philpem/NABU-Adaptor/LTSpice/PowerOnReset.asc

C1: polcap; 10µ; V=4 Irms=120m Rser=5.1 Lser=0 mfg="Vishay" pn="293D106M004A" type="Tantalum"
D1: diode; 1N4148
R1: res; 3k3
R2: res; 1k5
R3: res; 12k
U1: LT1017
V1: voltage; 5
V2: voltage; 1.4
Named nets: 0
.tran .5 startup
