philpem/NABU-Adaptor/Kicad/NABUAdaptor.kicad_sch

## KiCad design Kicad/NABUAdaptor.kicad_sch (2024-06-13, an earlier design)

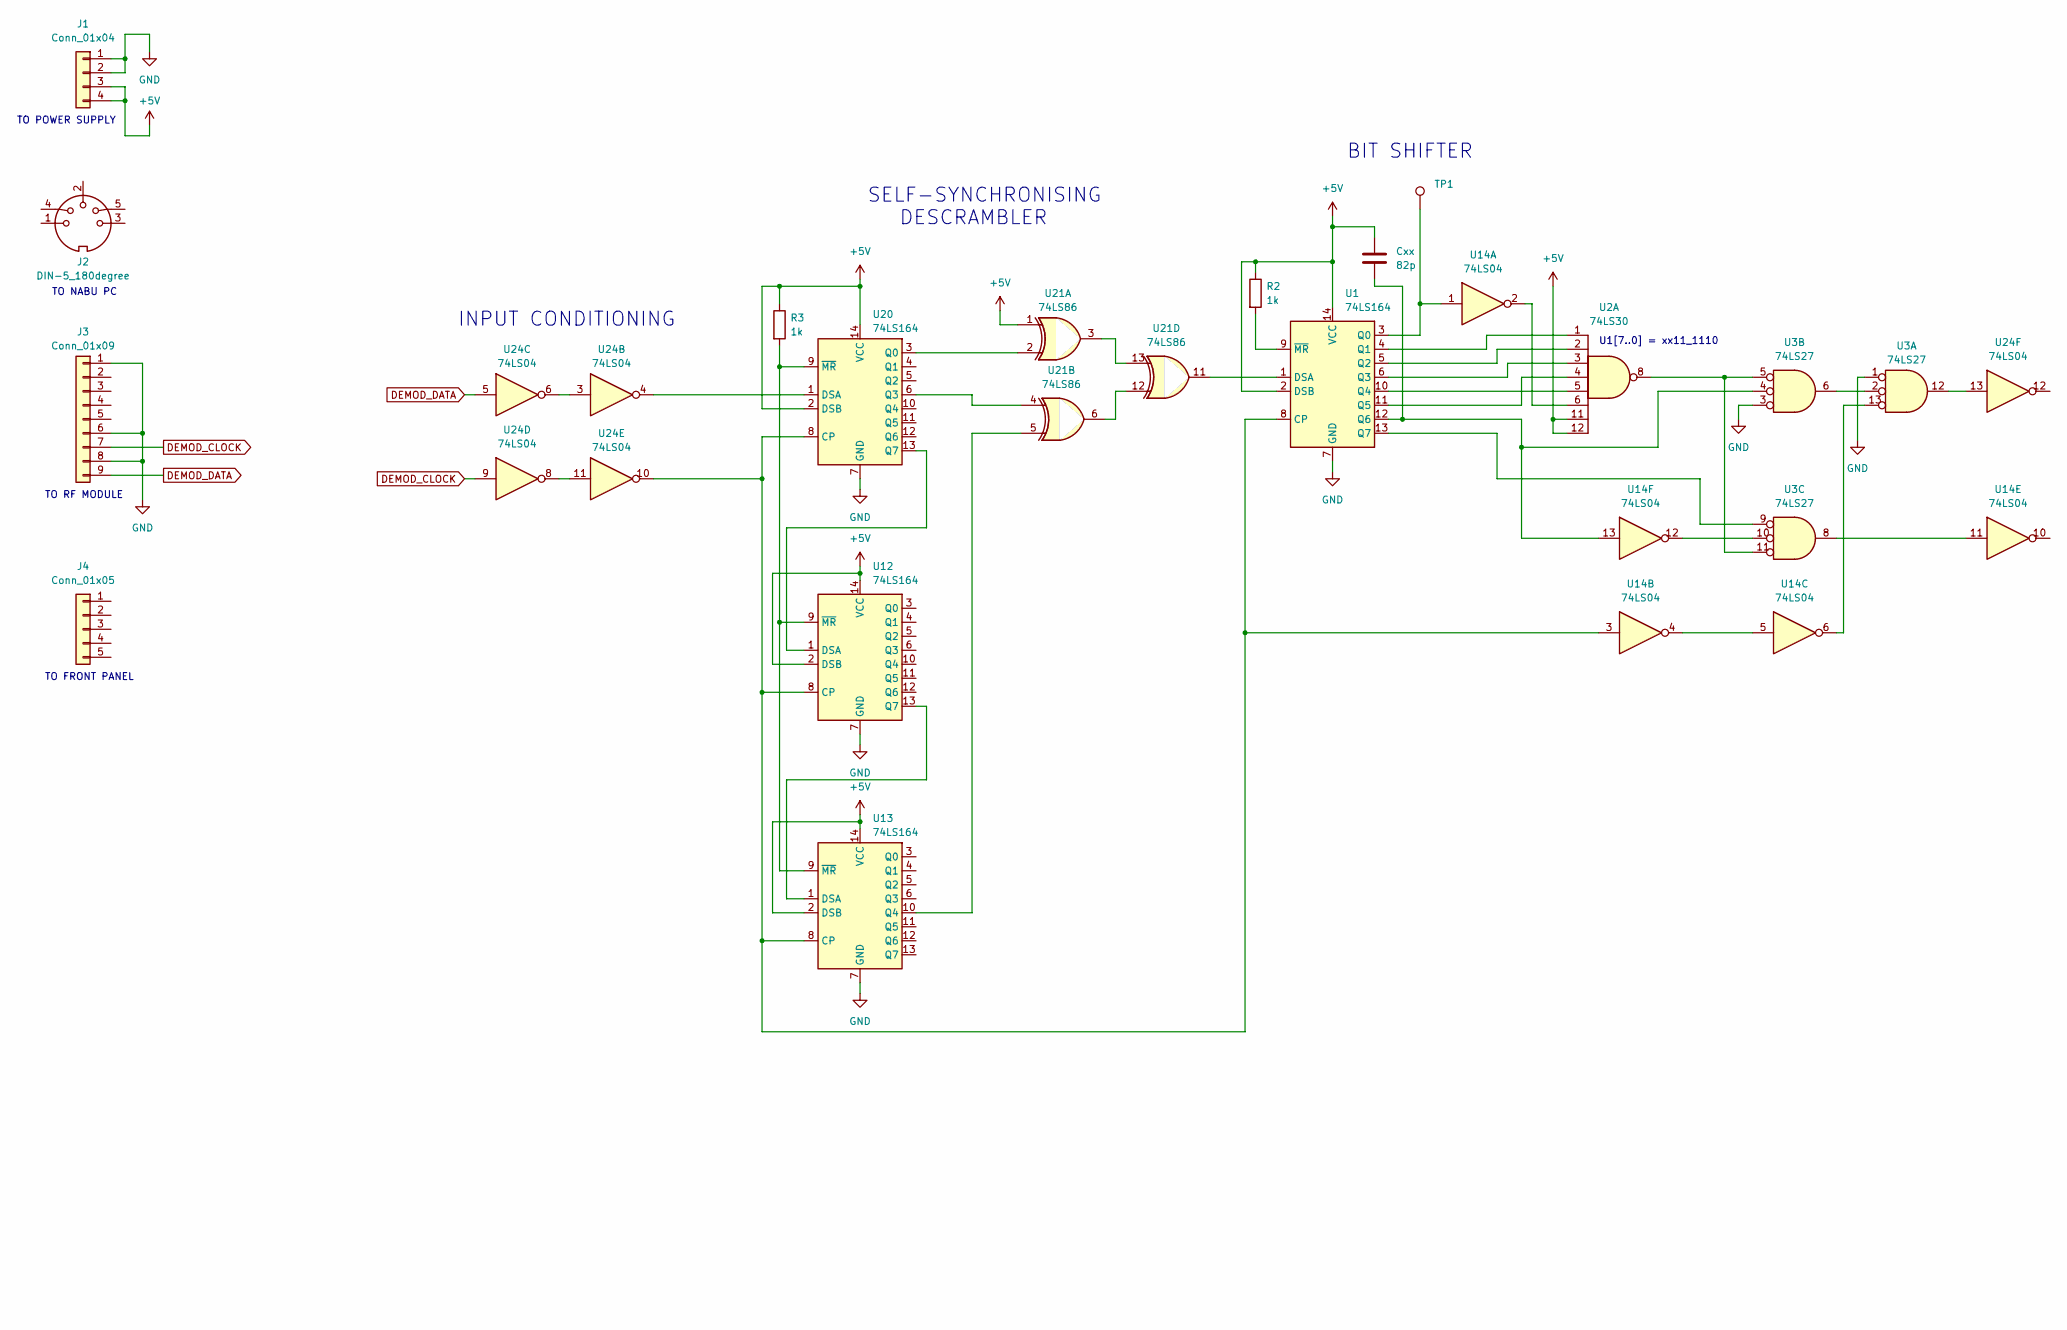
[picture p1: schematic NABUAdaptor.kicad_sch, part in row 1, column 1]

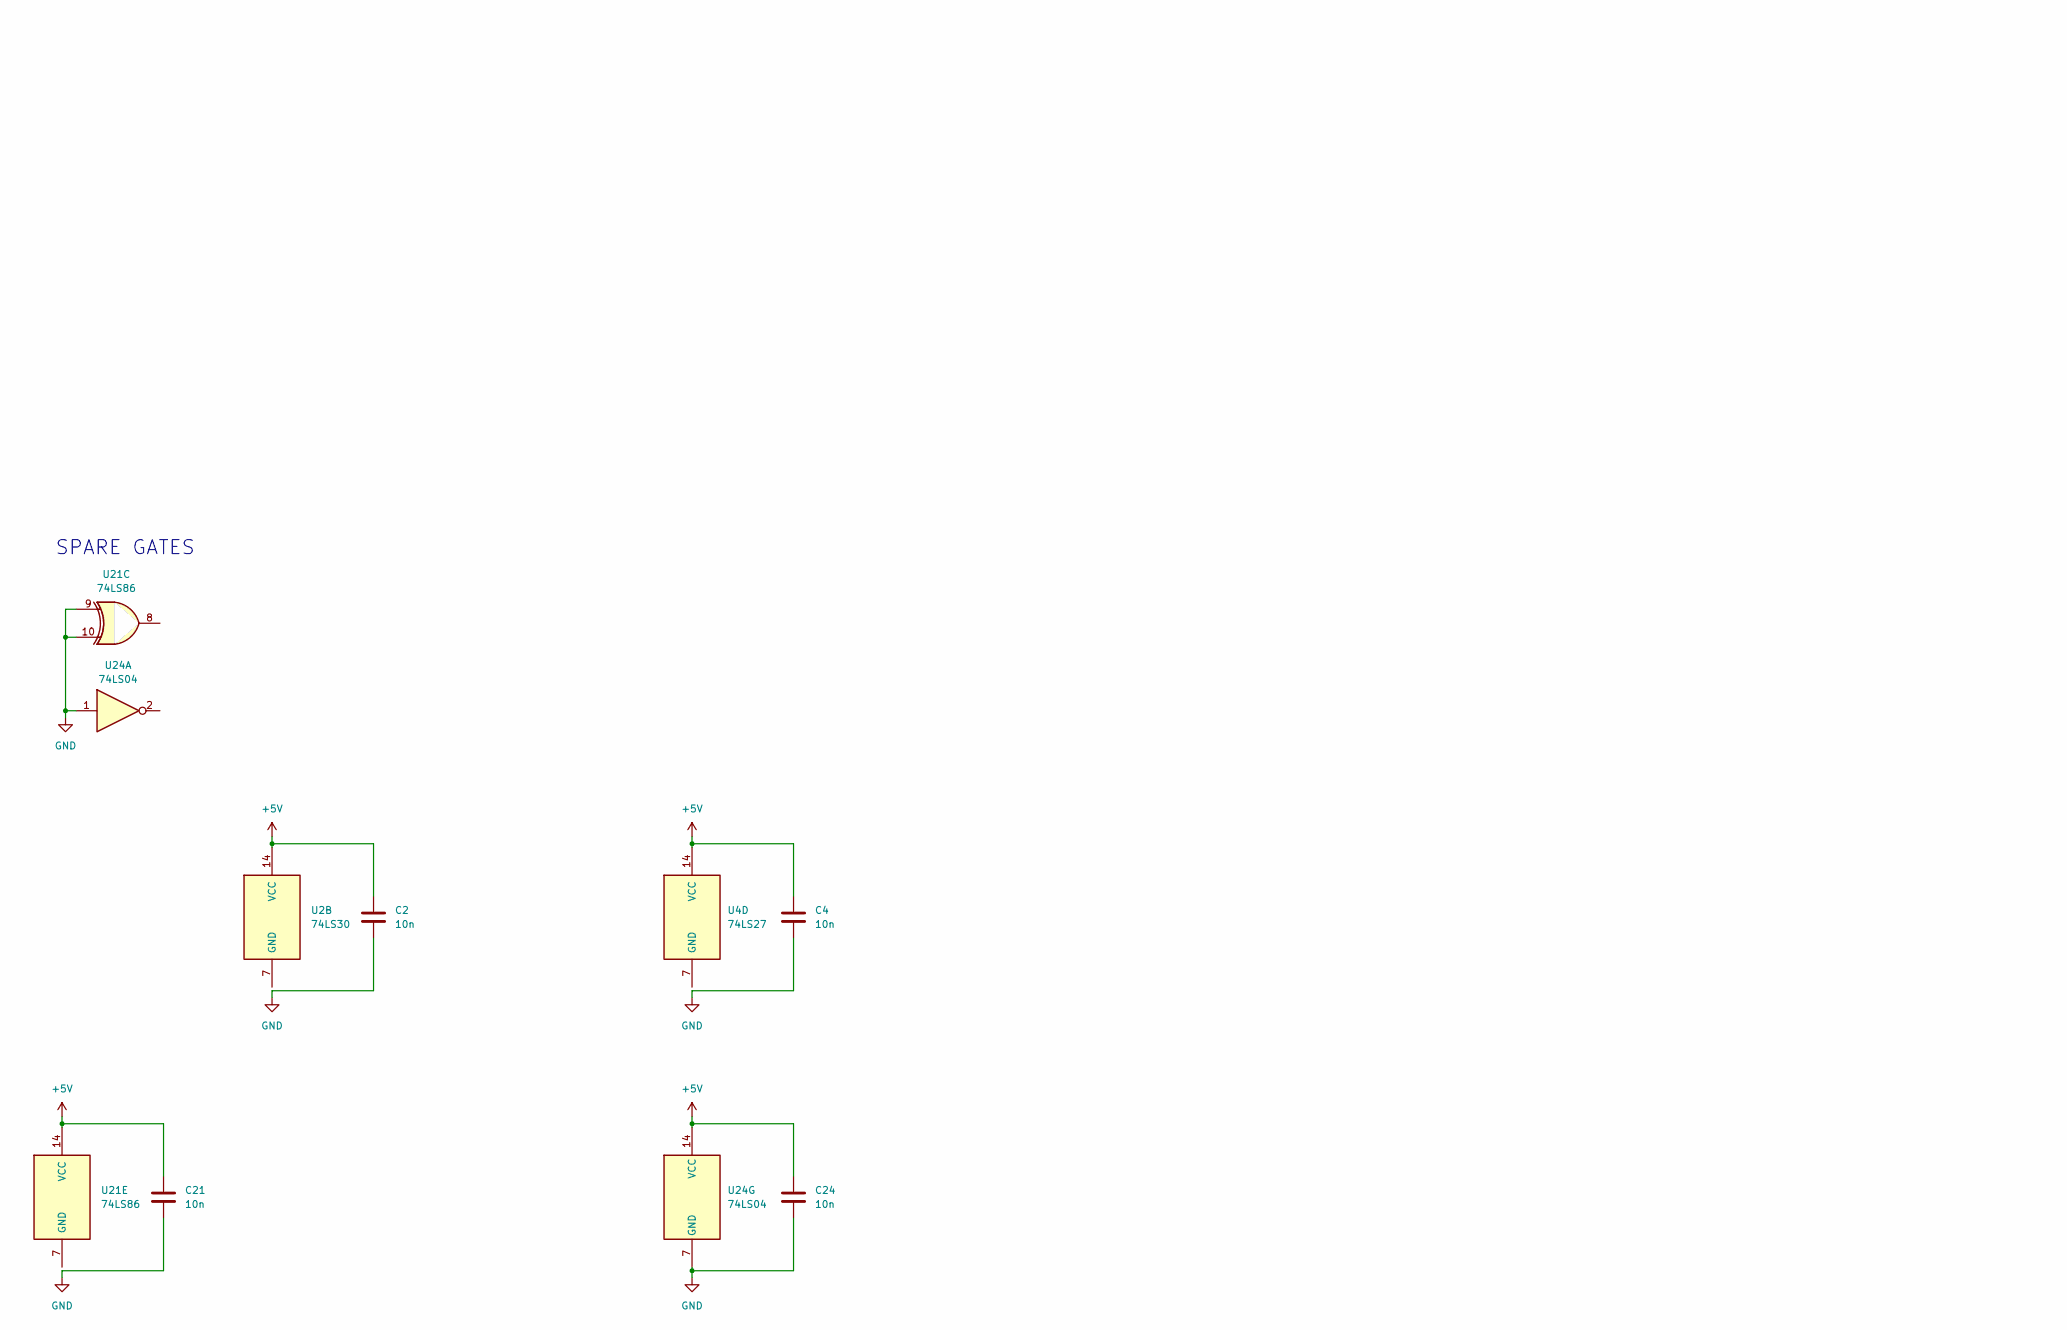
[picture p2: schematic NABUAdaptor.kicad_sch, part in row 2, column 1]

Parts:
C2, C4, C21, C24: 10n
Cxx: 82p
J1: Conn_01x04
J2: DIN-5_180degree
J3: Conn_01x09
J4: Conn_01x05
R2, R3: 1k
TP1: TestPoint
U1, U12, U13, U20: 74LS164
U2: 74LS30
U3, U4: 74LS27
U14, U24: 74LS04
U21: 74LS86

Connections:
+5V: C2.1, C4.1, C21.1, C24.1, Cxx.1, J1.3, J1.4, R2.1, R3.1, U1.2 (DSB), U1.14 (VCC), U2.11, U2.12, U2.14 (VCC), U4.14 (VCC), U12.2 (DSB), U12.14 (VCC), U13.2 (DSB), U13.14 (VCC), U20.2 (DSB), U20.14 (VCC), U21.1, U21.14 (VCC), U24.14 (VCC)
DEMOD_CLOCK: J3.7, U24.9
DEMOD_DATA: J3.9, U24.5
GND: C2.2, C4.2, C21.2, C24.2, J1.1, J1.2, J3.1, J3.6, J3.8, U1.7 (GND), U3.1, U3.3, U12.7 (GND), U13.7 (GND), U20.7 (GND), U21.9, U21.10, U24.1, U24.7 (GND)
unnamed: Cxx.2, U1.12 (Q6), U3.4, U14.13
unnamed: R2.2, U1.9 (~MR)
unnamed: R3.2, U12.9 (~MR), U13.9 (~MR), U20.9 (~MR)
unnamed: TP1.1, U1.3 (Q0), U14.1
unnamed: U1.1 (DSA), U21.11
unnamed: U1.4 (Q1), U2.1
unnamed: U1.5 (Q2), U2.2
unnamed: U1.6 (Q3), U2.3
unnamed: U1.8 (CP), U12.8 (CP), U13.8 (CP), U14.3, U20.8 (CP), U24.10
unnamed: U1.10 (Q4), U2.5
unnamed: U1.11 (Q5), U2.4
unnamed: U1.13 (Q7), U3.9
unnamed: U2.8, U3.5, U3.11
unnamed: U3.2, U3.6
unnamed: U12.1 (DSA), U20.13 (Q7)
unnamed: U12.13 (Q7), U13.1 (DSA)
unnamed: U13.10 (Q4), U21.5
unnamed: U2.6, U14.2
unnamed: U14.4, U14.5
unnamed: U3.13, U14.6
unnamed: U3.8, U14.11
unnamed: U3.10, U14.12
unnamed: U20.1 (DSA), U24.4
unnamed: U20.3 (Q0), U21.2
unnamed: U20.6 (Q3), U21.4
unnamed: U21.6, U21.12
unnamed: U21.3, U21.13
unnamed: U24.3, U24.6
unnamed: U24.8, U24.11
unnamed: U3.12, U24.13

Notes on the sheet:
TO POWER SUPPLY
TO FRONT PANEL
U1[7..0] = xx11_1110
BIT SHIFTER
SPARE GATES
TO NABU PC
TO RF MODULE
SELF-SYNCHRONISING DESCRAMBLER
INPUT CONDITIONING
