philpem/NABU-Adaptor/NABU-RP2040-Datapump/packets.h

// Packet data for 000001

const uint8_t DATA_000001_blk0[] = {
	0x00, 0x00, 0x01, 0x00, 0x01, 0x7F, 0xFF, 0xFF, 
	0xFF, 0x7F, 0x80, 0xA1, 0x00, 0x00, 0x00, 0x00, 
	0xD5, 0x00, 0xF3, 0x18, 0x11, 0x42, 0x4F, 0x4F, 
	0x54, 0x50, 0x20, 0x56, 0x45, 0x52, 0x53, 0x49, 
	0x4F, 0x4E, 0x20, 0x33, 0x2E, 0x30, 0x31, 0x03, 
	0x00, 0x3E, 0xC9, 0x32, 0x00, 0x00, 0xCD, 0x00, 
	0x00, 0x2A, 0x01, 0x00, 0x11, 0x23, 0x00, 0xB7, 
	0xED, 0x52, 0x22, 0xFA, 0x0F, 0xDD, 0x2A, 0xFA, 
	0x0F, 0xDD, 0x23, 0xDD, 0x23, 0xDD, 0x5E, 0x00, 
	0xDD, 0x56, 0x01, 0xDD, 0x19, 0xDD, 0x56, 0x01, 
	0xDD, 0x5E, 0x00, 0x1B, 0x1B, 0xED, 0x53, 0x04, 
	0x00, 0xDD, 0x46, 0x08, 0xDD, 0x4E, 0x09, 0xED, 
	0x43, 0x13, 0x00, 0xDD, 0x46, 0x05, 0xDD, 0x4E, 
	0x06, 0xED, 0x43, 0x08, 0x00, 0x01, 0x0C, 0x00, 
	0xDD, 0x09, 0xDD, 0x22, 0x06, 0x00, 0xDD, 0x19, 
	0xDD, 0x4E, 0x00, 0xDD, 0x46, 0x01, 0xDD, 0x23, 
	0xDD, 0x23, 0xDD, 0x7E, 0x06, 0x32, 0x0C, 0x00, 
	0x5F, 0xDD, 0x7E, 0x07, 0x32, 0x0D, 0x00, 0xB3, 
	0x20, 0x0A, 0x3E, 0x00, 0x32, 0x0C, 0x00, 0x3E, 
	0xC0, 0x32, 0x0D, 0x00, 0xDD, 0x09, 0xDD, 0x2B, 
	0xDD, 0x22, 0x0A, 0x00, 0x2A, 0x0C, 0x00, 0x09, 
	0x2B, 0xEB, 0x2A, 0x0A, 0x00, 0xED, 0xB8, 0xED, 
	0x4B, 0x04, 0x00, 0x2A, 0x06, 0x00, 0xED, 0x5B, 
	0x08, 0x00, 0xED, 0x7B, 0x0C, 0x00, 0x3E, 0xED, 
	0x32, 0x0E, 0x00, 0x3E, 0xB0, 0x32, 0x0F, 0x00, 
	0x3E, 0xC3, 0x32, 0x10, 0x00, 0xDD, 0x2A, 0x0C, 
	0x00, 0xDD, 0x23, 0xDD, 0x23, 0xDD, 0x23, 0xDD, 
	0x22, 0x11, 0x00, 0xDD, 0x2A, 0x13, 0x00, 0xDD, 
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
	0xCC, 0xEF, 0x22, 0x06, 0x00, 0x01, 0x00, 0x00, 
	0xCD, 0x92, 0xEC, 0x5F, 0xCD, 0x92, 0xEC, 0x57, 
	0x13, 0x7A, 0xB3, 0x1B, 0x20, 0x04, 0xED, 0x5B, 
	0xCA, 0xEF, 0x7A, 0xB3, 0x28, 0x16, 0xED, 0x4B, 
	0xCC, 0xEF, 0x60, 0x69, 0x19, 0x22, 0xCC, 0xEF, 
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

const uint8_t DATA_000001_blk53[] = {
	0x00, 0x00, 0x01, 0x35, 0x01, 0x7F, 0xFF, 0xFF, 
	0xFF, 0x7F, 0x80, 0x30, 0x35, 0x00, 0xCD, 0x2B, 
	0x7C, 0xD3, 0xA1, 0x00, 0x00, 0x00, 0x00, 0x00, 
	0x79, 0xD3, 0xA0, 0x00, 0x00, 0x00, 0x13, 0x23, 
	0x10, 0xD7, 0xC3, 0xC9, 0xF1, 0x41, 0x7C, 0xF6, 
	0x40, 0x67, 0xCD, 0xBE, 0xF1, 0x7B, 0xD3, 0xA1, 
	0x7A, 0xD3, 0xA1, 0x00, 0x00, 0x00, 0x00, 0x00, 
	0x00, 0x00, 0x00, 0xDB, 0xA0, 0x00, 0x00, 0x00, 
	0x00, 0x00, 0x4F, 0x7D, 0xD3, 0xA1, 0x7C, 0xD3, 
	0xA1, 0x00, 0x00, 0x00, 0x00, 0x00, 0x79, 0xD3, 
	0xA0, 0x00, 0x00, 0x00, 0x1B, 0x2B, 0x10, 0xD5, 
	0xC3, 0xC9, 0xF1, 0x1E, 0xD0, 0x55, 0x69, 0x26, 
	0x00, 0xCB, 0x25, 0xCB, 0x25, 0xED, 0x4B, 0xB7, 
	0xF1, 0x09, 0x44, 0x4D, 0xCD, 0xB6, 0xF2, 0x23, 
	0x44, 0x4D, 0x5A, 0xC3, 0xB6, 0xF2, 0x2A, 0xB7, 
	0xF1, 0x23, 0x18, 0x03, 0x2A, 0xB7, 0xF1, 0x23, 
	0x23, 0x06, 0x00, 0xCB, 0x21, 0xCB, 0x21, 0x09, 
	0x44, 0x4D, 0xC3, 0xB6, 0xF2, 0x00, 0x00, 0x00, 
	0x00, 0x00, 0x00, 0x00, 0x00, 0x00, 0x00, 0x00, 
	0x00, 0x00, 0x00, 0x42, 0x09, };
const uint32_t DATA_000001_NSEGS = 54;
const uint8_t* const DATA_000001_SEGS[54] = {
	DATA_000001_blk0,
	DATA_000001_blk1,
	DATA_000001_blk2,
	DATA_000001_blk3,
	DATA_000001_blk4,
	DATA_000001_blk5,
	DATA_000001_blk6,
	DATA_000001_blk7,
	DATA_000001_blk8,
	DATA_000001_blk9,
	DATA_000001_blk10,
	DATA_000001_blk11,
	DATA_000001_blk12,
	DATA_000001_blk13,
	DATA_000001_blk14,
	DATA_000001_blk15,
	DATA_000001_blk16,
	DATA_000001_blk17,
	DATA_000001_blk18,
	DATA_000001_blk19,
	DATA_000001_blk20,
	DATA_000001_blk21,
	DATA_000001_blk22,
	DATA_000001_blk23,
	DATA_000001_blk24,
	DATA_000001_blk25,
	DATA_000001_blk26,
	DATA_000001_blk27,
	DATA_000001_blk28,
	DATA_000001_blk29,
	DATA_000001_blk30,
	DATA_000001_blk31,
	DATA_000001_blk32,
	DATA_000001_blk33,
	DATA_000001_blk34,
	DATA_000001_blk35,
	DATA_000001_blk36,
	DATA_000001_blk37,
	DATA_000001_blk38,
	DATA_000001_blk39,
	DATA_000001_blk40,
	DATA_000001_blk41,
	DATA_000001_blk42,
	DATA_000001_blk43,
	DATA_000001_blk44,
	DATA_000001_blk45,
	DATA_000001_blk46,
	DATA_000001_blk47,
	DATA_000001_blk48,
	DATA_000001_blk49,
	DATA_000001_blk50,
	DATA_000001_blk51,
	DATA_000001_blk52,
	DATA_000001_blk53,
};
const uint16_t DATA_000001_SEGLENS[54] = {
	1009,1009,1009,1009,1009,1009,1009,1009,
	1009,1009,1009,1009,1009,1009,1009,1009,
	1009,1009,1009,1009,1009,1009,1009,1009,
	1009,1009,1009,1009,1009,1009,1009,1009,
	1009,1009,1009,1009,1009,1009,1009,1009,
	1009,1009,1009,1009,1009,1009,1009,1009,
	1009,1009,1009,1009,1009, 157,};
