philpem/NABU-Adaptor/(commit log)

2024-03-25 README: add link to RealDeuce's schematic
2024-03-25 Add PCB scans and WIP Kicad files
    [NABUAdaptor.kicad_pcb, NABUAdaptor.kicad_sch]
2024-03-25 Update Kicad schematic - more frame sync reversing
    [NABUAdaptor.kicad_sch]
2024-03-25 kicad: fix polarity of U2a output
    [NABUAdaptor.kicad_sch]
2024-03-25 kicad: add more U15/U22 wiring
    [NABUAdaptor.kicad_sch]
2024-04-17 Update schematic - just about done now
    [NABUAdaptor.kicad_sch]
2024-04-17 minor cleanup
    [NABUAdaptor.kicad_sch]
2024-04-17 resize for A1, tweak layout
    [NABUAdaptor.kicad_sch]
2024-04-17 huge cleanup, rename some nets based on function
    [NABUAdaptor.kicad_sch]
2024-04-17 fix up PLL/demod pin names
    [NABUAdaptor.kicad_sch]
2024-04-17 clean up MCU timer osc, add C37 value, calculate frequency
    [NABUAdaptor.kicad_sch]
2024-04-17 tidy around oscs, add reset circuit timing, add LTSpice POR model
    [NABUAdaptor.kicad_sch]
2024-04-18 Add more pin descriptions
    [NABUAdaptor.kicad_sch]
2024-04-18 sch: move interrupt logic closer to MCU
    [NABUAdaptor.kicad_sch]
2024-04-18 add more comp values, C40, and PAL pin names
    [NABUAdaptor.kicad_sch]
2024-04-18 sch: HDLC_FLAG_Q is inverted
    [NABUAdaptor.kicad_sch]
2024-04-23 kicad: add sym-lib-table
2024-04-23 schematic: Fix U7 OE wiring
    [NABUAdaptor.kicad_sch]
2024-06-13 Add Arduino data generator code
2024-06-13 schematic: fix signal polarities
    [NABUAdaptor.kicad_sch]
2024-06-17 Add notes on NPC/NA comms protocol and NA cable protocol
2024-06-17 Add preliminary (broken) RP2040 Datapump
    This uses a Raspberry Pi Pico to send data to the NABU Adaptor via the
    demodulator interface connector.
    It currently only sort-of-works, because the RP2040 isn't fast enough to
    generate the data stream and scramble it in realtime.
    [NABU-RP2040-Datapump.ino, packets.h]
2024-06-22 Remove test code
    Don't loop the same dma buffer over and over, d'oh
2024-06-22 Apply scrambling bytewise
    With thanks to @ejmount for the suggestion of applying the LFSR
    scrambler more than one bit at a time.
    Outcome is this goes from 120 instructions to 20 when testing on
    Godbolt.org for GCC 14.1.0 ARM, -O3 -mthumb -mcpu=cortex-m0
    -msoft-float.
    I don't think I need to sit and calculate the speed improvement, the 6:1
    opcode reduction is probably a good enough stat (followed by my
    reaction, which was: "oh.")
2024-06-30 Move bb_commit code out, move scrambling onto DMA core
